sntxxd/LUX-ONE/WIRING/diagrama github con resisDOS.png

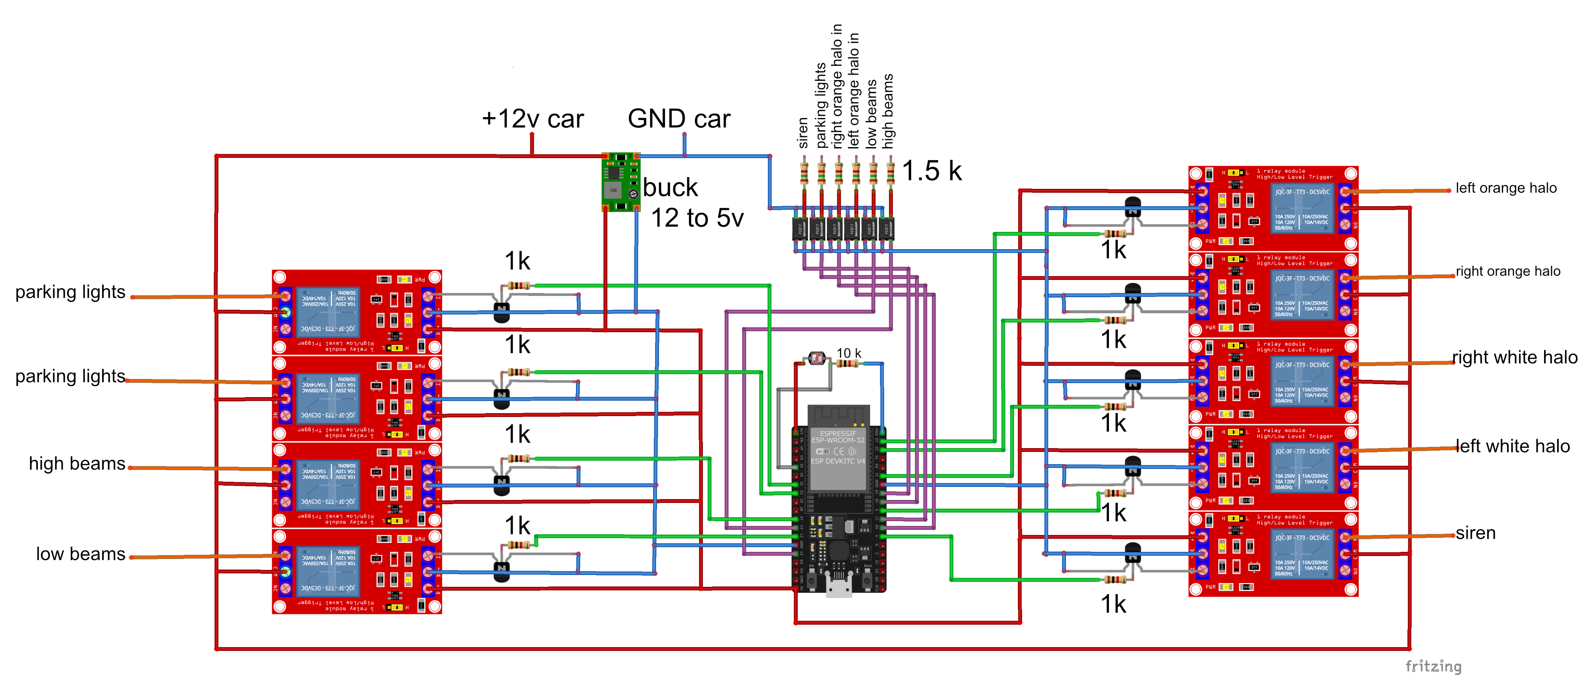
WIRING/diagrama github con resisDOS.png
