sntxxd/LUX-ONE/(commit log)

2026-09-20 Respaldo inicial: firmware ESP32 y app Android
2026-09-26 SYNTX 0.3: conexion en segundo plano y control por switch
2026-10-16 Create cad
2026-10-16 cad upload
2026-10-16 Add new connections for English section in wiring doc
2026-10-30 Expand LUX ONE guide with installation and pairing details
    Added detailed instructions for installation, first connection, appearance settings, adding devices, and pending hardware tests.
2026-10-30 Revise README for clarity and additional details
    Updated README to clarify project details, wiring, and security protocols.
2026-10-30 Update README with new wiring diagram image
    Added a new image to the wiring section of the README.
2026-10-30 Modify CAD file size limit message
    Updated message regarding file size limit and download link.
2026-10-30 Update README with guide location and device compatibility
    Added note about detailed guide location and compatibility with Android devices.
2026-10-30 Revise wiring instructions in README
    Updated wiring instructions for low and high beams connection and clarified resistor usage.
2026-10-30 Clarify relay descriptions and status in README
    Updated relay descriptions in README for clarity and added 'NOT ENABLED YET' notes for specific relays.
2026-10-30 Enhance README with images and CAD information
    Added images and CAD section to README.
